Sergeant-Salz/Speed-O-Matic/atmega88_based_pcb/atmega88_based_pcb.kicad_pcb

## KiCad design atmega88_based_pcb/atmega88_based_pcb.kicad_pcb (2025-03-24)

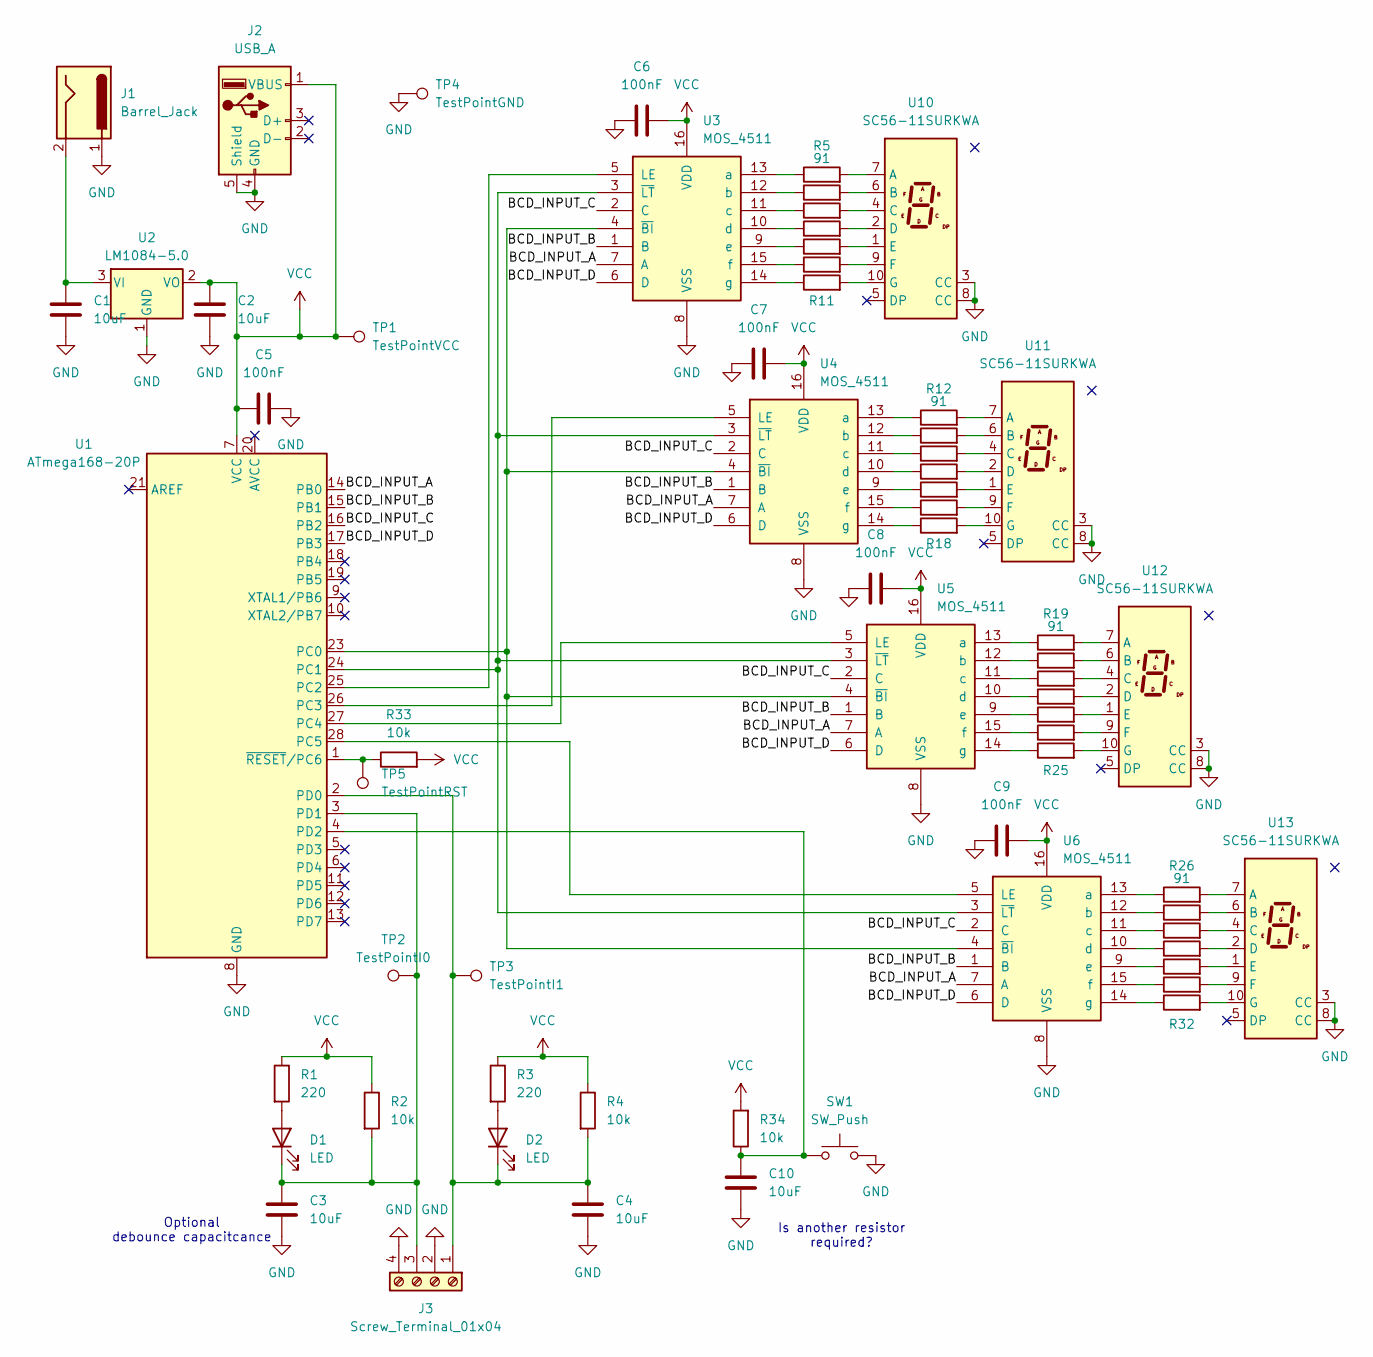
[picture p2: schematic atmega88_based_pcb.kicad_sch]

Parts:
C1, C2, C3, C4, C10: 10uF; CP_Radial_D10.0mm_P5.00mm
C5, C6, C7, C8, C9: 100nF; C_Axial_L3.8mm_D2.6mm_P7.50mm_Horizontal
D1, D2: LED; LED_D5.0mm
J1: Barrel_Jack; BarrelJack_CLIFF_FC68148S_SMT_Horizontal
J2: USB_A; USB_A_ASSMAN_AW
J3: Screw_Terminal_01x04; TerminalBlock_Phoenix_MPT-0,5-4-2.54_1x04_P2.54mm_Horizontal
R1, R3: 220; R_Axial_DIN0207_L6.3mm_D2.5mm_P7.62mm_Horizontal
R2, R4, R33, R34: 10k; R_Axial_DIN0207_L6.3mm_D2.5mm_P7.62mm_Horizontal
R5, R6, R7, R8, R9, R10, R11, R12, R13, R14, R15, R16, R17, R18, R19, R20, R21, R22, R23, R24, R25, R26, R27, R28, R29, R30, R31, R32: 91; R_Axial_DIN0207_L6.3mm_D2.5mm_P7.62mm_Horizontal
SW1: SW_Push; SW_SPST_Omron_B3F-40xx
TP1: TestPointVCC; TestPoint_Pad_1.0x1.0mm
TP2: TestPointI0; TestPoint_Pad_1.0x1.0mm
TP3: TestPointI1; TestPoint_Pad_1.0x1.0mm
TP4: TestPointGND; TestPoint_Pad_1.0x1.0mm
TP5: TestPointRST; TestPoint_Pad_1.0x1.0mm
U1: ATmega168-20P; DIP-28_W7.62mm
U2: LM1084-5.0; TO-220-3_Vertical
U3, U4, U5, U6: MOS_4511; DIP-16_W7.62mm
U10, U11, U12, U13: SC56-11SURKWA; D1X8K

Connections:
/BCD_INPUT_A: U1.14 (PB0), U3.7 (A), U4.7 (A), U5.7 (A), U6.7 (A)
/BCD_INPUT_B: U1.15 (PB1), U3.1 (B), U4.1 (B), U5.1 (B), U6.1 (B)
/BCD_INPUT_C: U1.16 (PB2), U3.2 (C), U4.2 (C), U5.2 (C), U6.2 (C)
/BCD_INPUT_D: U1.17 (PB3), U3.6 (D), U4.6 (D), U5.6 (D), U6.6 (D)
GND: C1.1, C2.1, C3.1, C4.1, C5.1, C6.2, C7.2, C8.2, C9.2, C10.1, J1.1, J2.4 (GND), J2.5 (Shield), J3.2, J3.4, SW1.2, TP4.1, U1.8 (GND), U1.22 (GND), U2.1 (GND), U3.8 (VSS), U4.8 (VSS), U5.8 (VSS), U6.8 (VSS), U10.3 (CC), U10.8 (CC), U11.3 (CC), U11.8 (CC), U12.3 (CC), U12.8 (CC), U13.3 (CC), U13.8 (CC)
unnamed: D1.2 (A), R1.2
unnamed: C3.2, D1.1 (K), J3.3, R2.2, TP2.1, U1.3 (PD1)
unnamed: D2.2 (A), R3.2
unnamed: C4.2, D2.1 (K), J3.1, R4.2, TP3.1, U1.2 (PD0)
unnamed: U1.23 (PC0), U3.4 (~BI), U4.4 (~BI), U5.4 (~BI), U6.4 (~BI)
unnamed: U1.24 (PC1), U3.3 (~LT), U4.3 (~LT), U5.3 (~LT), U6.3 (~LT)
unnamed: U1.25 (PC2), U3.5 (LE)
unnamed: U1.26 (PC3), U4.5 (LE)
unnamed: U1.27 (PC4), U5.5 (LE)
unnamed: U1.28 (PC5), U6.5 (LE)
unnamed: C10.2, R34.1, SW1.1, U1.4 (PD2)
unnamed: R33.1, TP5.1, U1.1 (~RESET/PC6)
unnamed: C1.2, J1.2, U2.3 (VI)
unnamed: R5.1, U3.13 (a)
unnamed: R6.1, U3.12 (b)
unnamed: R7.1, U3.11 (c)
unnamed: R8.1, U3.10 (d)
unnamed: R9.1, U3.9 (e)
unnamed: R10.1, U3.15 (f)
unnamed: R11.1, U3.14 (g)
unnamed: R12.1, U4.13 (a)
unnamed: R13.1, U4.12 (b)
unnamed: R14.1, U4.11 (c)
unnamed: R15.1, U4.10 (d)
unnamed: R16.1, U4.9 (e)
unnamed: R17.1, U4.15 (f)
unnamed: R18.1, U4.14 (g)
unnamed: R19.1, U5.13 (a)
unnamed: R20.1, U5.12 (b)
unnamed: R21.1, U5.11 (c)
unnamed: R22.1, U5.10 (d)
unnamed: R23.1, U5.9 (e)
unnamed: R24.1, U5.15 (f)
unnamed: R25.1, U5.14 (g)
unnamed: R26.1, U6.13 (a)
unnamed: R27.1, U6.12 (b)
unnamed: R28.1, U6.11 (c)
unnamed: R29.1, U6.10 (d)
unnamed: R30.1, U6.9 (e)
unnamed: R31.1, U6.15 (f)
unnamed: R32.1, U6.14 (g)
unnamed: R5.2, U10.7 (A)
unnamed: R6.2, U10.6 (B)
unnamed: R7.2, U10.4 (C)
unnamed: R8.2, U10.2 (D)
unnamed: R9.2, U10.1 (E)
unnamed: R10.2, U10.9 (F)
unnamed: R11.2, U10.10 (G)
unnamed: R12.2, U11.7 (A)
unnamed: R13.2, U11.6 (B)
unnamed: R14.2, U11.4 (C)
unnamed: R15.2, U11.2 (D)
unnamed: R16.2, U11.1 (E)
unnamed: R17.2, U11.9 (F)
unnamed: R18.2, U11.10 (G)
unnamed: R19.2, U12.7 (A)
unnamed: R20.2, U12.6 (B)
unnamed: R21.2, U12.4 (C)
unnamed: R22.2, U12.2 (D)
unnamed: R23.2, U12.1 (E)
unnamed: R24.2, U12.9 (F)
unnamed: R25.2, U12.10 (G)
unnamed: R26.2, U13.7 (A)
unnamed: R27.2, U13.6 (B)
unnamed: R28.2, U13.4 (C)
unnamed: R29.2, U13.2 (D)
unnamed: R30.2, U13.1 (E)
unnamed: R31.2, U13.9 (F)
unnamed: R32.2, U13.10 (G)
VCC: C2.2, C5.2, C6.1, C7.1, C8.1, C9.1, J2.1 (VBUS), R1.1, R2.1, R3.1, R4.1, R33.2, R34.2, TP1.1, U1.7 (VCC), U2.2 (VO), U3.16 (VDD), U4.16 (VDD), U5.16 (VDD), U6.16 (VDD)

Notes on the sheet:
Optional debounce capacitcance
Is another resistor required?

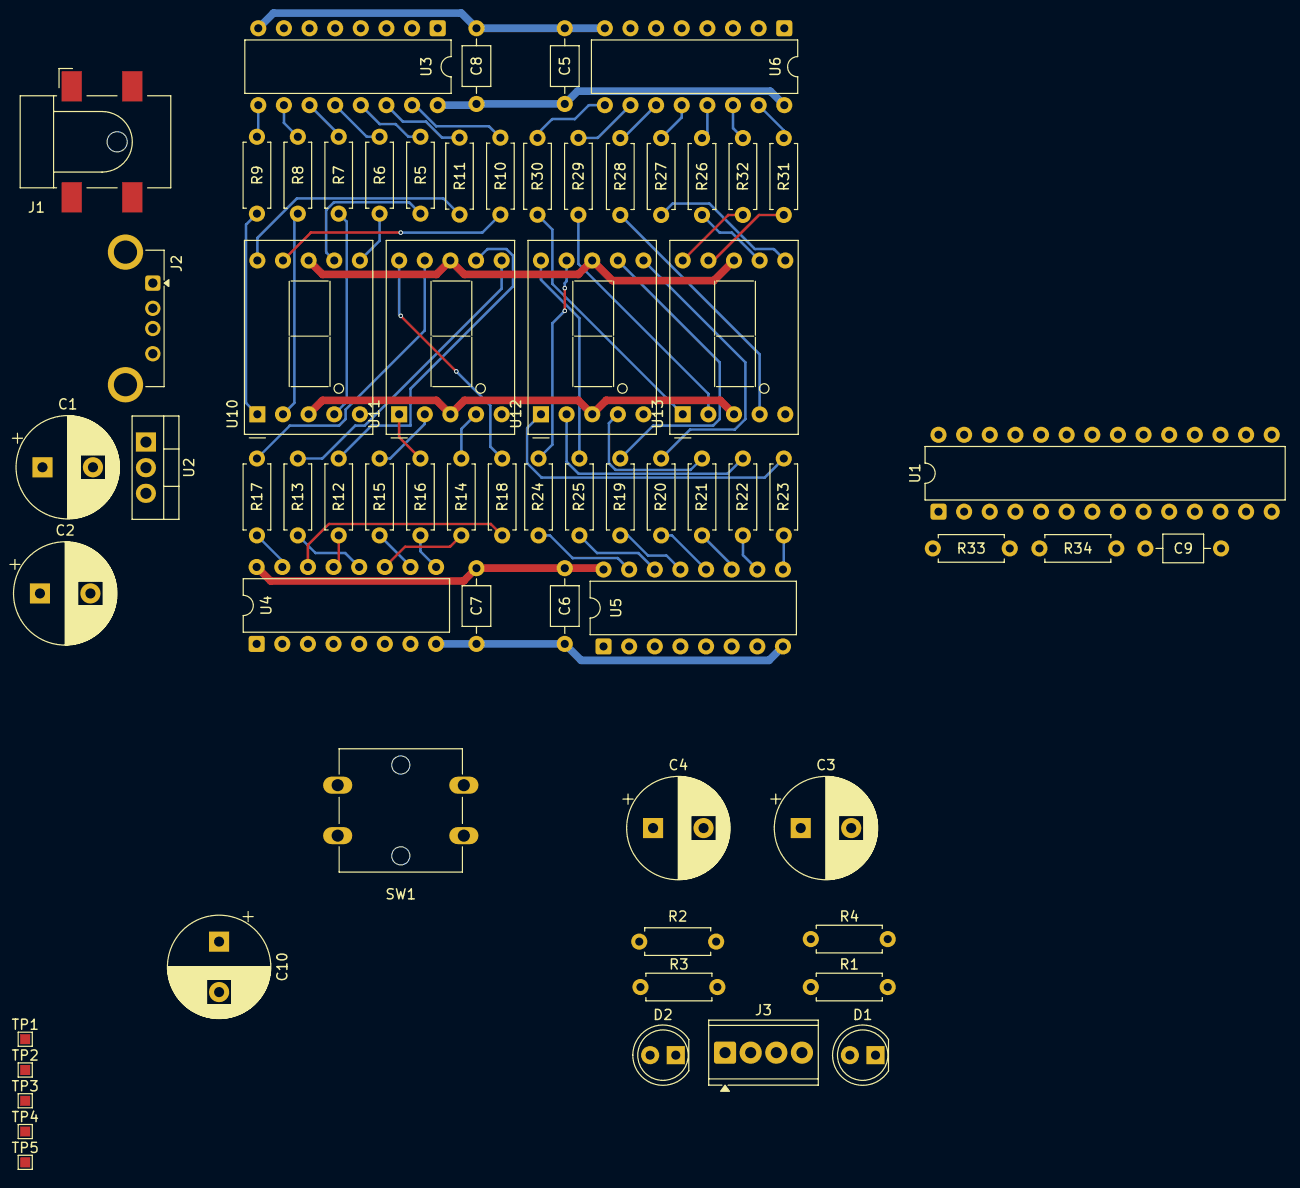
[picture p3: board atmega88_based_pcb.kicad_pcb from above]

Board: 2 copper layers, 65 parts (0 on the bottom side), 75 nets.
