Sergeant-Salz/Speed-O-Matic/(threads)

Thread 2 (2025-04-24):

Replace USB-A Connector

Sergeant-Salz, 2025-04-24:
The board currently includes a footprint for a USB-A connector, originally intended as an alternate power source. However, USB-A is poorly suited for this purpose. Consider replacing it with a USB micro-B or USB-C connector, or removing it altogether in future revisions.

Thread 3 (2025-04-24):

Reduce LED Brightness

Sergeant-Salz, 2025-04-24:
The displays may actually be *too* bright for some conditions. In future revisions, consider using higher-value segment resistors to reduce brightness and power consumption, especially for indoor or low-light use.

Sergeant-Salz, 2025-04-25:
For a software solution, we may consider connecting the light blank signal to a PWM pin
