Sergeant-Salz/Speed-O-Matic/(commit log)

2025-03-23 Initial arduino src code commit
2025-03-23 Fixed INIT transition, interrupt pins and logging improvement
    [board_arduino_uno.h, lichtschranke.ino, lichtschranke_src.ino]
2025-03-24 Fix latching for display drivers Fix time delta computation
    [lichtschranke.ino, lichtschranke_src.ino]
2025-03-24 Initial commit of KiCad files
    [atmega88_based_pcb.kicad_pcb, atmega88_based_pcb.kicad_sch]
2025-04-15 Small fixes to comments and debug macro
    [lichtschranke.ino, lichtschranke_src.ino]
2025-04-15 Added ATmega168 board pin definitions
2025-04-15 Tied AVCC to VCC and changed interrupt pins to use PD3/4 for external interrupts instead of PCINT
    [atmega88_based_pcb.kicad_sch]
2025-04-24 Added some page metadata to schematic
    [atmega88_based_pcb.kicad_sch]
2025-04-24 Added schematic to README
2025-04-24 Added more general attach/detachInterrupt overwrites
2025-04-24 Added reset button support
2025-04-24 Fixed number display order
    [lichtschranke.ino]
2025-04-24 Changed interrupt order to match user intuition
2025-04-24 Improved overview section, added LED brightness issue
2025-04-27 Added photograph of finished PCB to README
2025-05-12 Removed interrupt ordering constraint Added microsecond display mode
2025-05-12 Fixed flash interval in microsecond mode
    [controller_src.ino, lichtschranke.ino]
